InfinatEmber/3DScanner_ME401Final/display/images/scan1.jpg

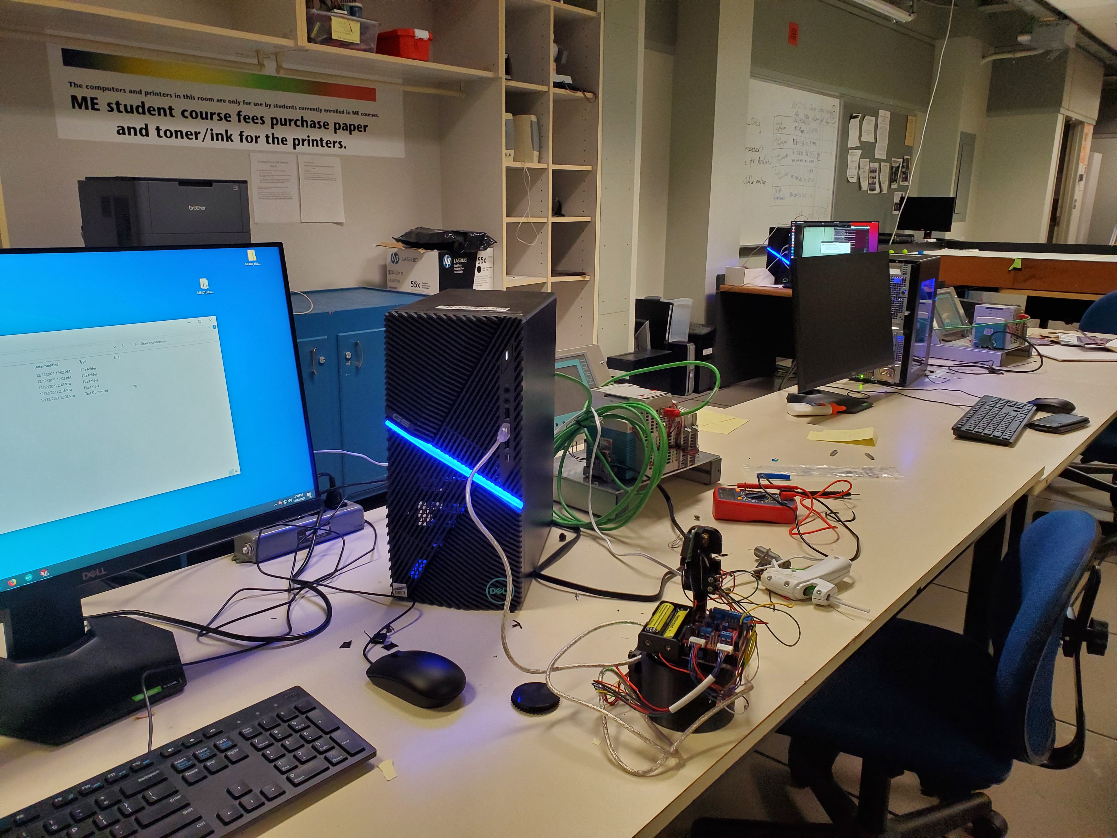
display/images/scan1.jpg
