InfinatEmber/3DScanner_ME401Final/display/images/under.jpg

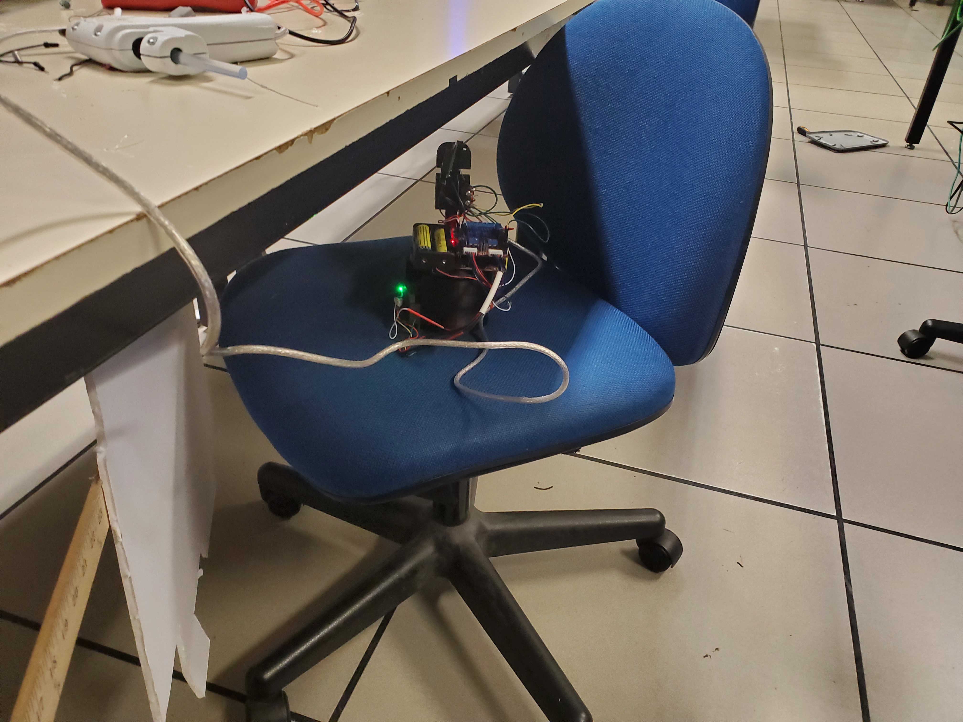
display/images/under.jpg
