InfinatEmber/3DScanner_ME401Final/display/corner.png

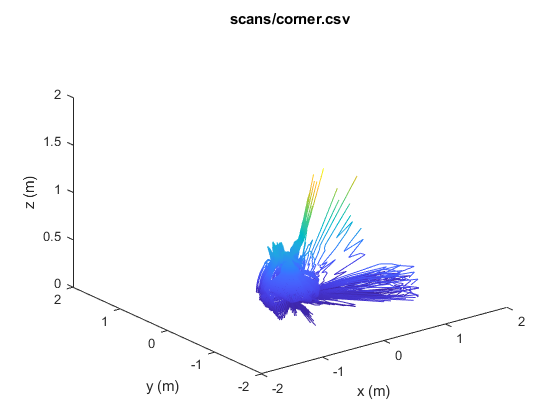
display/corner.png
