InfinatEmber/3DScanner_ME401Final/display/cornerb.png

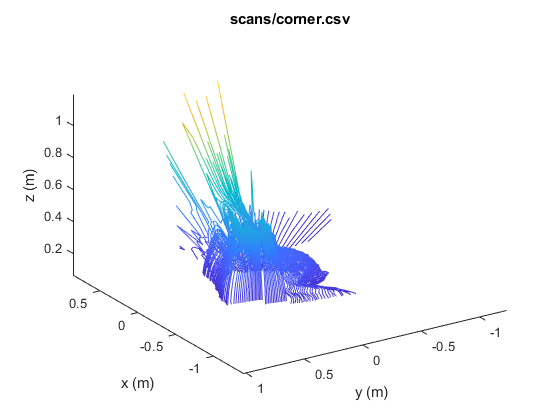
display/cornerb.png
