InfinatEmber/3DScanner_ME401Final/display/cornerc.png

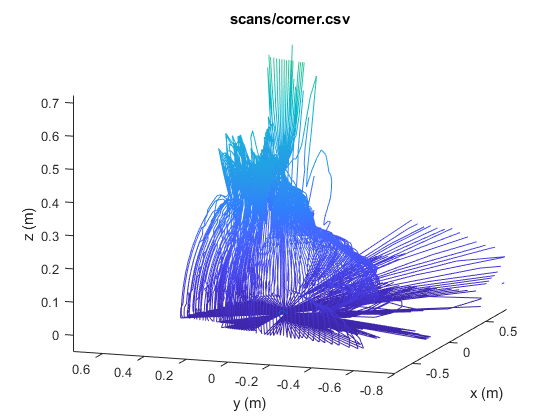
display/cornerc.png
