InfinatEmber/3DScanner_ME401Final/display/cornerd.png

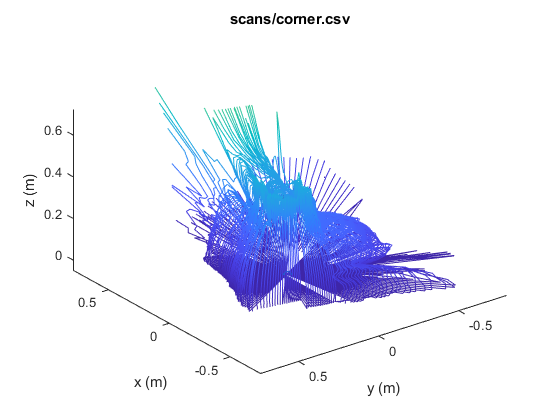
display/cornerd.png
