InfinatEmber/3DScanner_ME401Final/display/images/corner.jpg

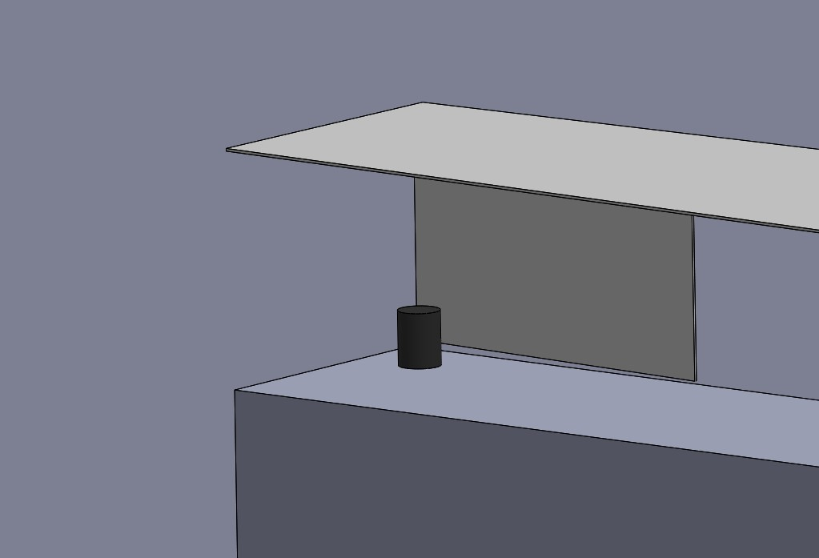
display/images/corner.jpg
