InfinatEmber/3DScanner_ME401Final/display/images/rcorner.jpg

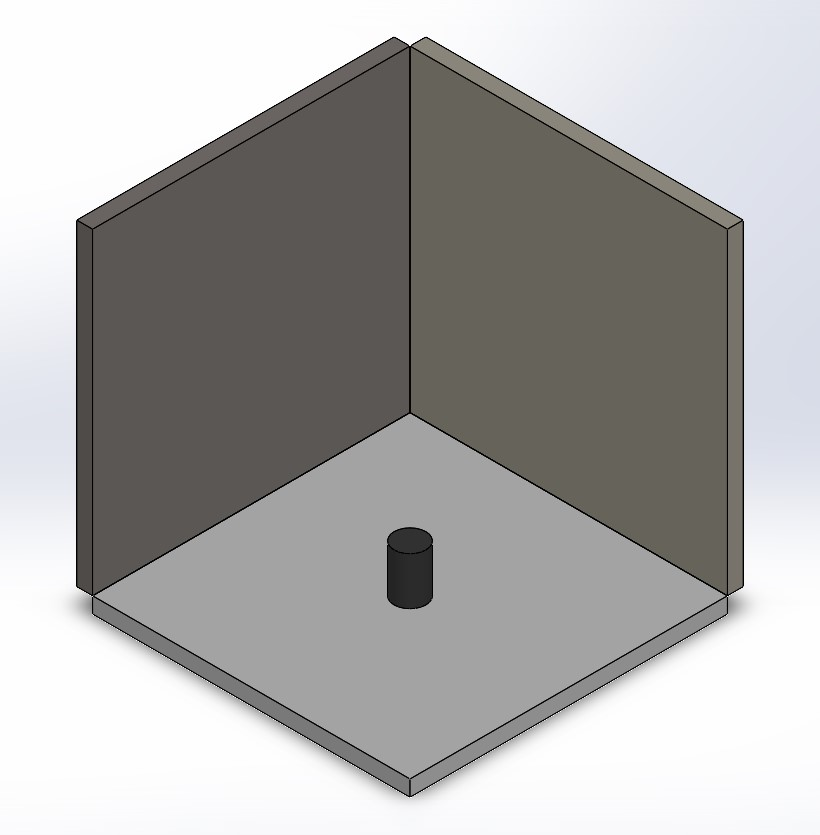
display/images/rcorner.jpg
