InfinatEmber/3DScanner_ME401Final/display/images/rwall.jpg

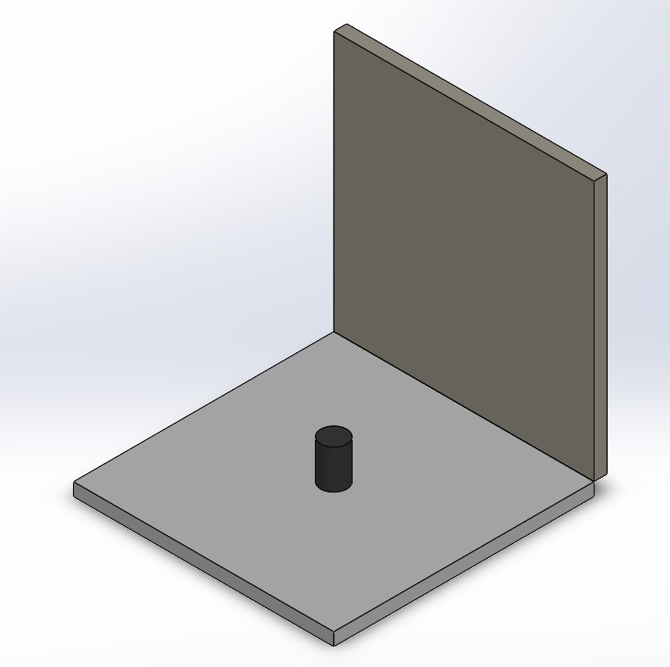
display/images/rwall.jpg
