InfinatEmber/3DScanner_ME401Final/display/images/walls.jpg

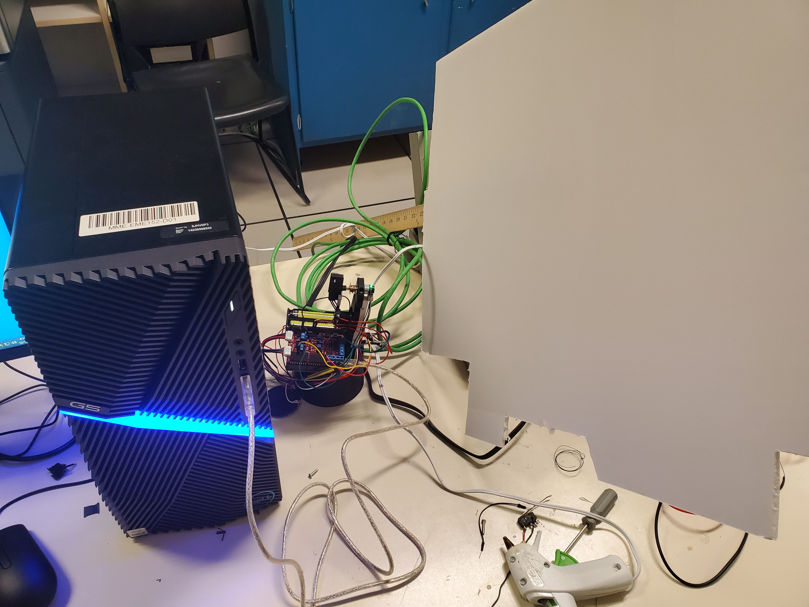
display/images/walls.jpg
