InfinatEmber/3DScanner_ME401Final/display/rcorner.png

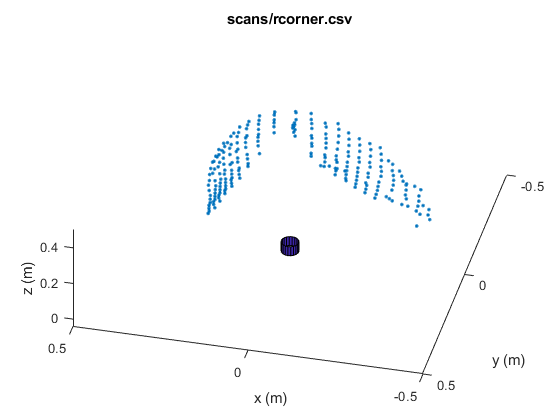
display/rcorner.png
