InfinatEmber/3DScanner_ME401Final/display/rwall2.png

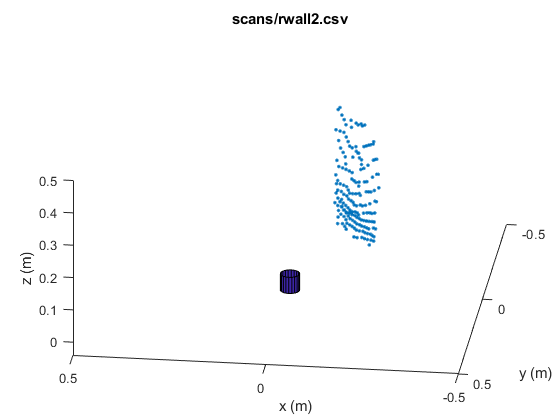
display/rwall2.png
