InfinatEmber/3DScanner_ME401Final/display/scan1.png

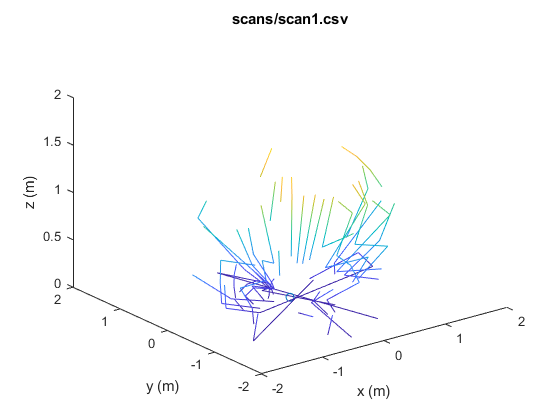
display/scan1.png
