InfinatEmber/3DScanner_ME401Final/display/under.png

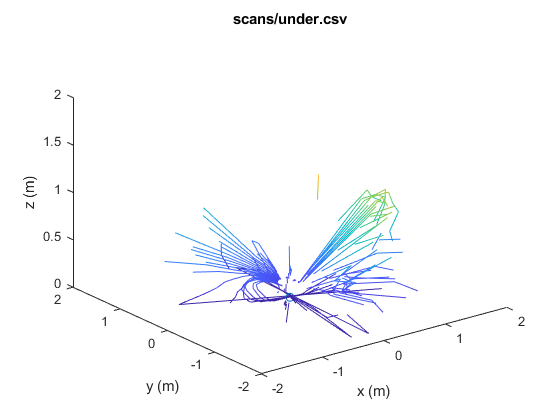
display/under.png
