InfinatEmber/3DScanner_ME401Final/display/underb.png

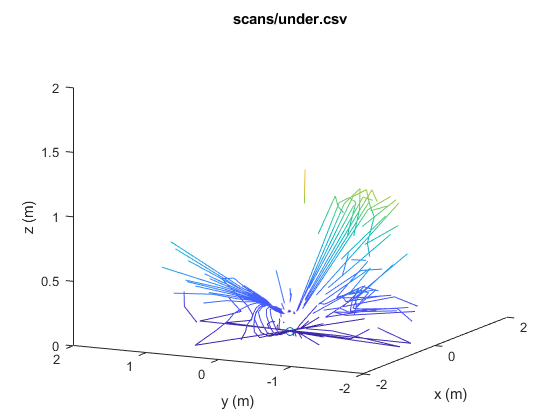
display/underb.png
