InfinatEmber/3DScanner_ME401Final/display/underc.png

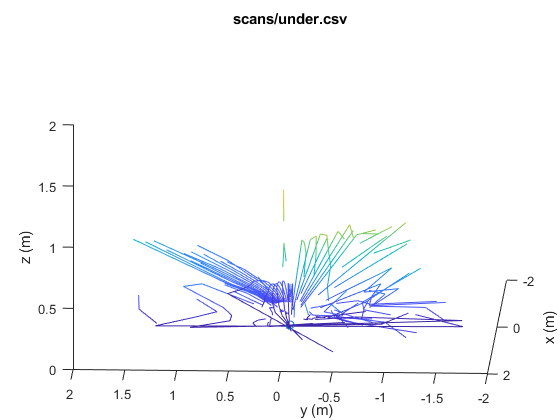
display/underc.png
