InfinatEmber/3DScanner_ME401Final/display/walls.png

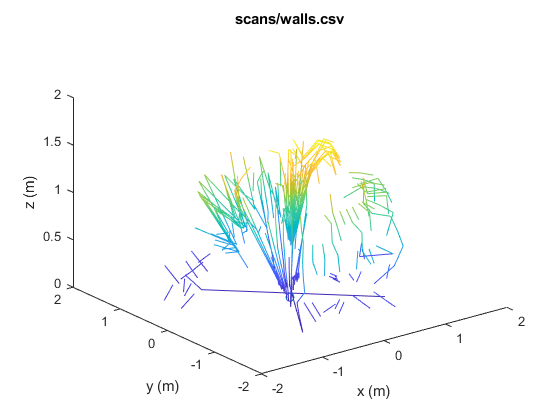
display/walls.png
