InfinatEmber/3DScanner_ME401Final/display/wallsb.png

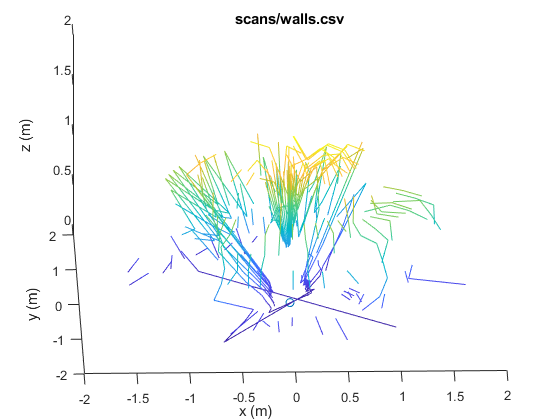
display/wallsb.png
