InfinatEmber/3DScanner_ME401Final/calibration/pitch stuff.xlsx

Sheet: settling
Column1 | Column2 | Column3 | Column4 | Column5 | Column6 | Column7
1.2 | 6.56 | 0.05 | 0 | 0 | 13.29 | 4210258
1.2 | 6.56 | 0.05 | 0 | 0 | 13.29 | 4210361
1.2 | 6.56 | 0.05 | 0 | 0 | 13.29 | 4210464
1.2 | 6.56 | 0.05 | 0 | 0 | 13.29 | 4210567
1.2 | 6.56 | 0.05 | 0 | 0 | 13.29 | 4210670
1.2 | 6.56 | 0.05 | 0 | 0 | 13.29 | 4210773
1.2 | 6.56 | 0.05 | 0 | 0 | 13.29 | 4210876
1.2 | 6.56 | 0.05 | 0 | 0 | 13.29 | 4210979
1.2 | 6.56 | 0.05 | 0 | 0 | 13.29 | 4211082
1.2 | 6.56 | 0.05 | 0 | 0 | 13.29 | 4211185
1.2 | 6.56 | 0.05 | 0 | 0 | 13.29 | 4211288
1.2 | 6.56 | 0.05 | 0 | 0 | 13.29 | 4211391
1.2 | 6.56 | 0.05 | 400 | 0 | 13.29 | 4212494
1.2 | 6.56 | 0.05 | 400 | 415 | -43.42 | 4212597
1.2 | 6.56 | 0.05 | 400 | 478 | 20.52 | 4212700
1.2 | 6.56 | 0.05 | 400 | 475 | -15.66 | 4212803
1.2 | 6.56 | 0.05 | 400 | 440 | -3.04 | 4212906
1.2 | 6.56 | 0.05 | 400 | 419 | -1.49 | 4213009
1.2 | 6.56 | 0.05 | 400 | 410 | -14.85 | 4213112
1.2 | 6.56 | 0.05 | 400 | 405 | -4.34 | 4213215
1.2 | 6.56 | 0.05 | 400 | 403 | -15.11 | 4213318
1.2 | 6.56 | 0.05 | 400 | 403 | -17.07 | 4213421
1.2 | 6.56 | 0.05 | 400 | 400 | -14.52 | 4213524
1.2 | 6.56 | 0.05 | 400 | 400 | -14.52 | 4213627
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
