InfinatEmber/3DScanner_ME401Final/calibration/yaw stuff.xlsx

Sheet: Settling
Column1 | Column2 | Column3 | Column4 | Column5 | Column6 | Column7
1.5 | 6.59 | 0.09 | 0 | 0 | -8.34 | 1207792
1.5 | 6.59 | 0.09 | 0 | 0 | -8.34 | 1207895
1.5 | 6.59 | 0.09 | 0 | 0 | -8.34 | 1207998
1.5 | 6.59 | 0.09 | 0 | 0 | -8.34 | 1208101
1.5 | 6.59 | 0.09 | 0 | 0 | -8.34 | 1208204
1.5 | 6.59 | 0.09 | 0 | 0 | -8.34 | 1208307
1.5 | 6.59 | 0.09 | 0 | 0 | -8.34 | 1208410
1.5 | 6.59 | 0.09 | 400 | 0 | 255 | 1209513
1.5 | 6.59 | 0.09 | 400 | 357 | 41.53 | 1209616
1.5 | 6.59 | 0.09 | 400 | 449 | 47.58 | 1209719
1.5 | 6.59 | 0.09 | 400 | 454 | 28.82 | 1209822
1.5 | 6.59 | 0.09 | 400 | 453 | -8.23 | 1209925
1.5 | 6.59 | 0.09 | 400 | 444 | -19.11 | 1210028
1.5 | 6.59 | 0.09 | 400 | 428 | -9.88 | 1210131
1.5 | 6.59 | 0.09 | 400 | 417 | -16.11 | 1210234
1.5 | 6.59 | 0.09 | 400 | 409 | -21.77 | 1210337
1.5 | 6.59 | 0.09 | 400 | 408 | -25.61 | 1210440
1.5 | 6.59 | 0.09 | 400 | 403 | -23.63 | 1210543
1.5 | 6.59 | 0.09 | 400 | 399 | -9.08 | 1210646
1.5 | 6.59 | 0.09 | 400 | 399 | -16.85 | 1210749
1.5 | 6.59 | 0.09 | 400 | 399 | -16.19 | 1210852
1.5 | 6.59 | 0.09 | 400 | 399 | -15.54 | 1210955
1.5 | 6.59 | 0.09 | 400 | 399 | -14.88 | 1211058
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
