InfinatEmber/3DScanner_ME401Final/calibration/pitch settling graph.png

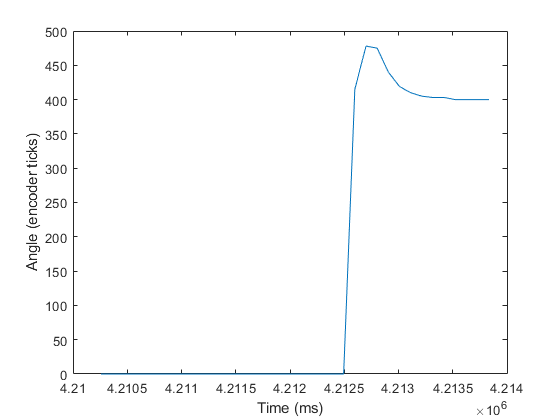
calibration/pitch settling graph.png
