InfinatEmber/3DScanner_ME401Final/calibration/pitch settling text.png

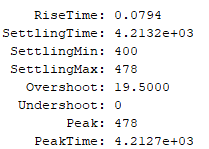
calibration/pitch settling text.png
