InfinatEmber/3DScanner_ME401Final/calibration/yaw settling graph.png

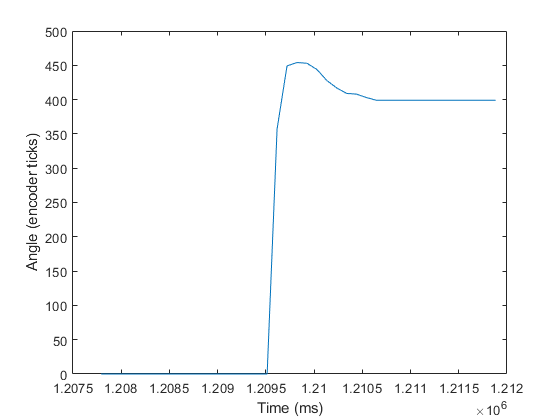
calibration/yaw settling graph.png
