InfinatEmber/3DScanner_ME401Final/calibration/yaw settling text.png

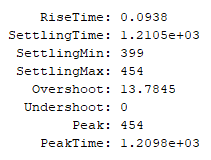
calibration/yaw settling text.png
