InfinatEmber/3DScanner_ME401Final/calibration/encoder_PID/encoder_PID.ino

/*
 * a lot of this was coded py Proffesor Swensen
 */

#include <SoftPWMServo.h>
#include <PID_v1.h>

// Global variables for keeping track of position
static volatile char lastLeftA;
static volatile char lastLeftB;
static volatile bool errorLeft;
volatile long position = 0;


double input=0, output=0, setpoint=0;

// TODO: STUDENTS NEED TO FIND THE RIGHT CONTROL GAINS FOR GOOD POSITION CONTROL

//double ku = 690;
//double tu = 0.133;

// kp=0.6*ku,ki=2*kp/tu,kd=kp*tu/8;
double kp =40, ki = 0, kd = 0;

PID myPID(&input, &output, &setpoint,kp,ki,kd, DIRECT);

int pidSampleTime = 10;
long counter=1; // This counter is used to determine when the control loop should run


void setup() {
  
  // Set up the serial port in case we want output or input
  Serial.begin(115200);
  Serial.println("Timer Interrupt Encoder Test:");
  
  // Set up the quadrature inputs
  pinMode(2, INPUT);
  pinMode(20, INPUT);
  
  errorLeft = false;
  lastLeftA = digitalRead(2);
  lastLeftB = digitalRead(20);
  
  attachCoreTimerService(MyCallback);
  
  // Set up the motor outputs
  pinMode(3, OUTPUT);
  pinMode(4, OUTPUT);
  
  digitalWrite(3,0);
  digitalWrite(4,0);
  
  SoftPWMServoPWMWrite(3, 0);
  
  
  //Setup the pid 
  myPID.SetMode(AUTOMATIC);
  myPID.SetSampleTime(pidSampleTime);
  myPID.SetOutputLimits(-255,255);
  Serial.print("Setpoint,Current,PWM,Time");
}



void loop() {
  
  long newPosition = position;
  
  // Allow the user to change the setpoint by typing either 'a' or 'z' into the serial monitor 
  if (Serial.available() > 0) 
  {
    String str = Serial.readString();

    char var = str[0];
    str.remove(0,2);
    float num = str.toFloat();
    switch(var) {
      case 'p':
        kp = num;
        break;
      case 'i':
        ki = num;
        break;
      case 'd':
        kd = num;
        break;
      case 's':
        setpoint = num;
        break;
      default:
        break;
    }
    myPID.SetTunings(kp,ki,kd);
  }
  Serial.print(kp);
  Serial.print(",");
  Serial.print(ki);
  Serial.print(",");
  Serial.print(kd);
  Serial.print(",");
  Serial.print(setpoint);
  Serial.print(",");
  Serial.print(input);
  Serial.print(",");
  Serial.print(output);
  Serial.print(",");
  Serial.print(millis());
  Serial.println("");
        
  delay(100);
        
}

/* For the core timer callback, just toggle the output high and low
   and schedule us for another 100uS in the future. CORE_TICK_RATE
   is the number of core timer counts in 1 millisecond. So if we 
   want this callback to be called every 10uS, we just divide 
   the CORE_TICK_RATE by 100, and add it to the current time.
   currentTime is the core timer clock time at the moment we get
   called
*/
uint32_t MyCallback(uint32_t currentTime) {
  char newLeftA = digitalRead(2);
  char newLeftB = digitalRead(20);
  
  position += (newLeftA ^ lastLeftB) - (lastLeftA ^ newLeftB);
  
  if((lastLeftA ^ newLeftA) & (lastLeftB ^ newLeftB))
    {
        errorLeft = true;
    }
  
  lastLeftA = newLeftA;
  lastLeftB = newLeftB;
    
  
  if (counter % 100*pidSampleTime == 0)
  {
    input = (double) position;      
        
    myPID.Compute();

    digitalWrite(4,output > 0);
    
    SoftPWMServoPWMWrite(3,abs(output));
    counter = 0;
  }
  counter++;
  
  return (currentTime + CORE_TICK_RATE/100);
}
