InfinatEmber/3DScanner_ME401Final/display/images/20211212_144956.jpg

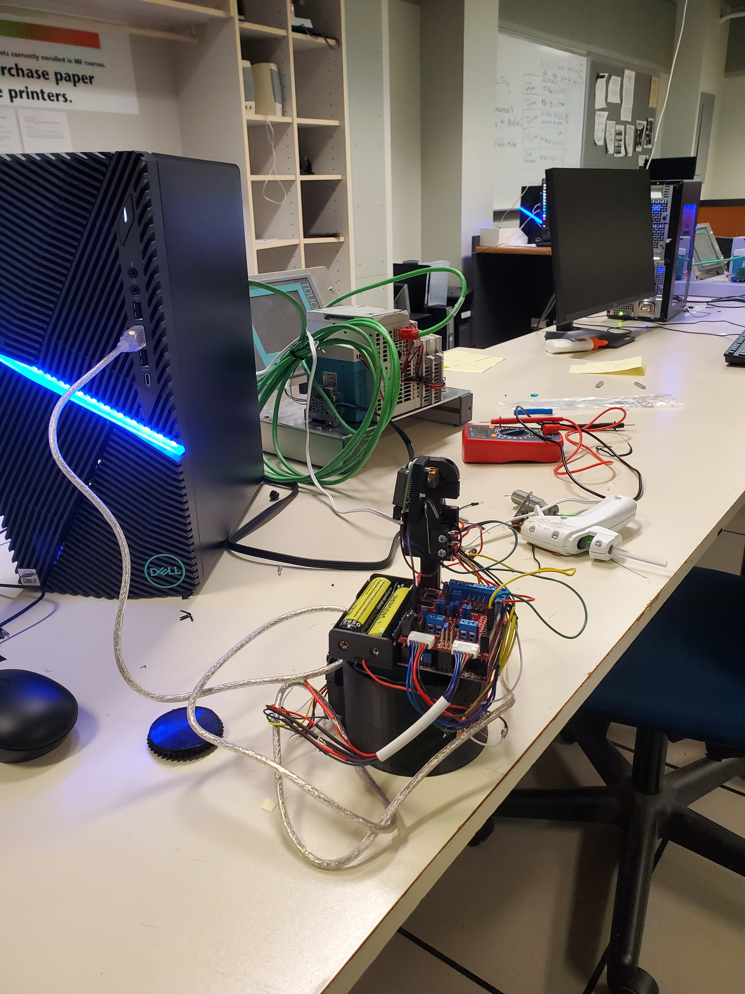
display/images/20211212_144956.jpg
